samuwall/hiiri-v1/README.md

### open-source wireless gaming mouse

mouse: nRF52820 + PAW3395 + SPDT L/R + EC10E

dongle: nRF52840
