samuwall/hiiri-v1/tools/README.md

### tools/

`hiiri-cfg.c`: mouse config GUI

`libusb-set.c`: mouse config CLI

`libusb-vbat.c`: read mouse battery level
