samuwall/hiiri-v1/hw/mouse/README.md

### hw/mouse

pcb made with KiCad

shell made with FreeCAD

warning: chip antenna is not impedance matched, RF performance is terrible. i plan on impedance matching hiiri-v2, which will use the new nRF54L.

---

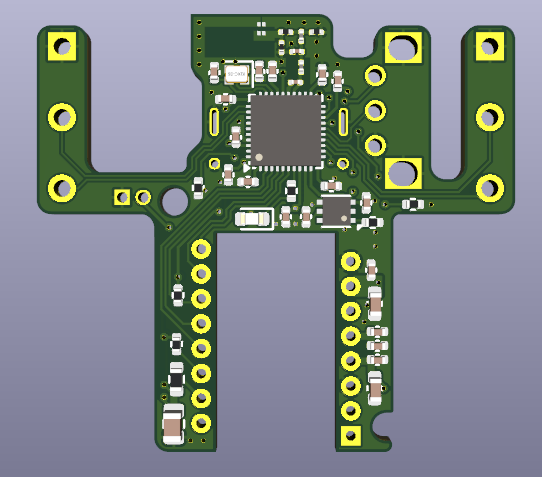
[picture p1: hw/mouse/pcb.png]

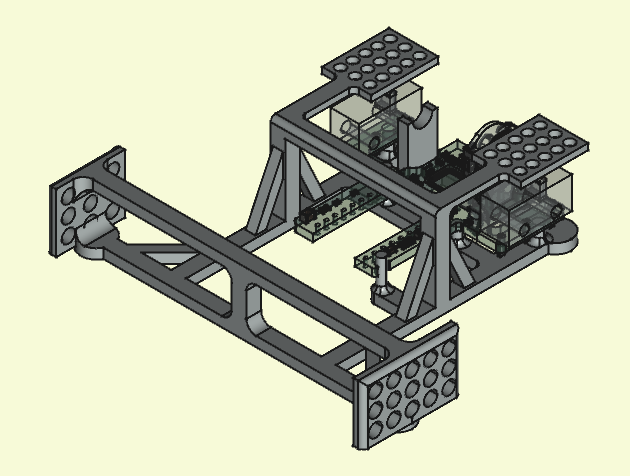
[picture p2: hw/mouse/shell.png]

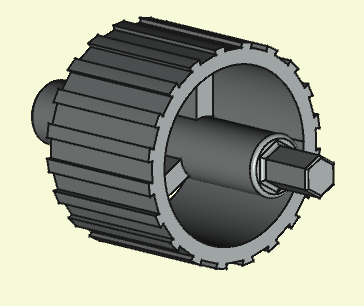
[picture p3: hw/mouse/scroll.png]
