samuwall/hiiri-v1/fw/dongle/README.md

### fw/dongle

firmware for an accompanying nRF52840 dongle

can use any board, just edit the `LED_PIN` macro
