samuwall/hiiri-v1/hw/dongle/README.md

### hw/dongle

any nRF52840 board with a USB connector and user LED will work, as long as `LED_PIN` from `fw/dongle/src/dongle.c` is edited accordingly.
