samuwall/hiiri-v1/hw/mouse/kicad/step-files/D2F_01F.step

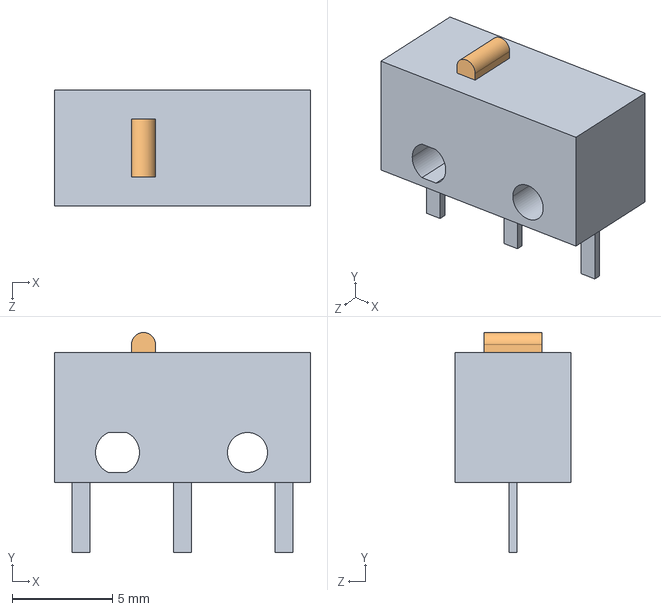
[picture p5: CAD file, 2025-09-14]
hw/mouse/kicad/step-files/D2F_01F.step
12.8 x 11.0 x 5.80 mm
D2F_01F_BASE
D2F_01F_ACTUATOR
