samuwall/hiiri-v1/hw/mouse/freecad/scroll.FCStd

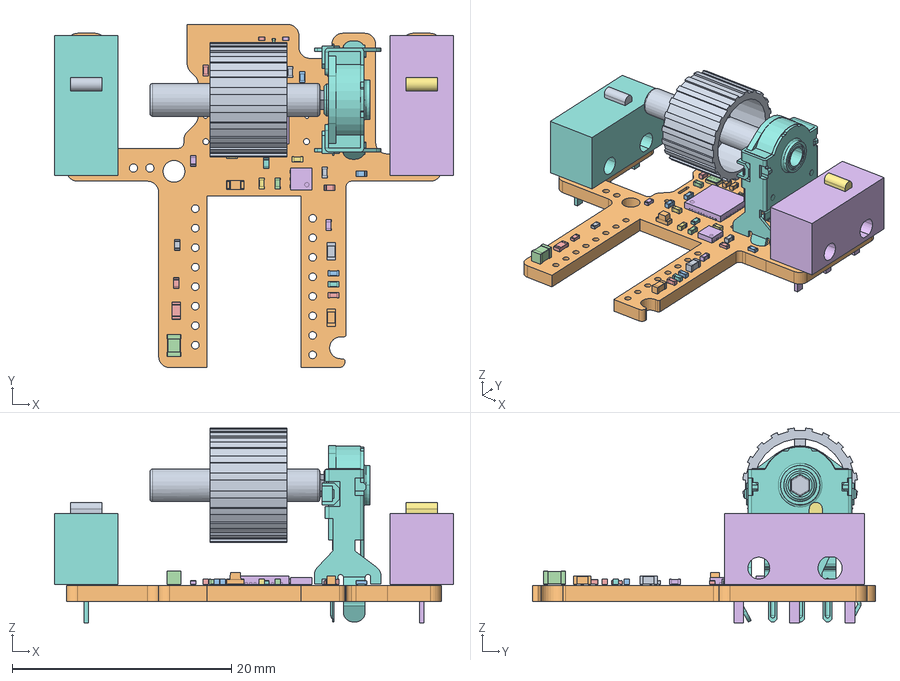
[picture p6: CAD file, 2025-09-14]
hw/mouse/freecad/scroll.FCStd
36.4 x 31.3 x 17.8 mm
C_0402_1005Metric
C_0402_1005Metric001
C_0805_2012Metric
R_0402_1005Metric
DFN-6-1EP_2x2mm_P0.65mm_EP1x1.6mm
C_0201_0603Metric
nrf52820_hiiri 1.7
R_0402_1005Metric001
C_0201_0603Metric001
C_0402_1005Metric002
R_0201_0603Metric
R_0201_0603Metric001
D2F_01F_BASE
D2F_01F_ACTUATOR
C_0402_1005Metric003
C_0603_1608Metric
C_0603_1608Metric001
R_0402_1005Metric002
C_0402_1005Metric004
R_0603_1608Metric
C_0402_1005Metric005
C_0402_1005Metric006
L_0201_0603Metric
C_0402_1005Metric007
LED_0603_1608Metric
C_0402_1005Metric008
C_0402_1005Metric009
R_0402_1005Metric003
QFN-40-1EP_5x5mm_P0.4mm_EP3.6x3.6mm
C_0402_1005Metric010
R_0402_1005Metric004
C_0402_1005Metric011
C_0402_1005Metric012
C_0402_1005Metric013
L_0201_0603Metric001
C_0402_1005Metric014
R_0201_0603Metric002
Pins
Pins001
Pins002
Pins003
Cover
C_0402_1005Metric015
R_0402_1005Metric005
C_0402_1005Metric016
D2F_01F_BASE001
D2F_01F_ACTUATOR001
nrf52820_hiiri_PCB
