samuwall/hiiri-v1/hw/mouse/kicad/step-files/EC10E1220501.step

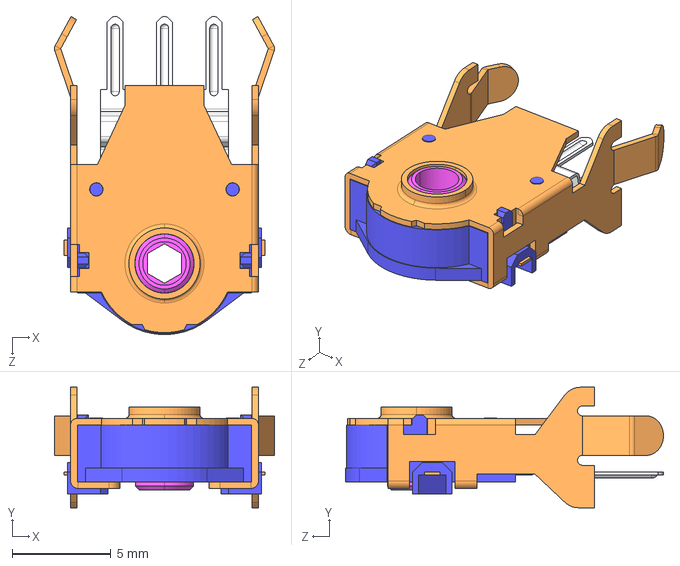
[picture p7: CAD file, 2025-09-14]
hw/mouse/kicad/step-files/EC10E1220501.step
11.1 x 6.10 x 16.1 mm
