samuwall/hiiri-v1/hw/mouse/kicad/step-files/XTAL_SMD1612.step

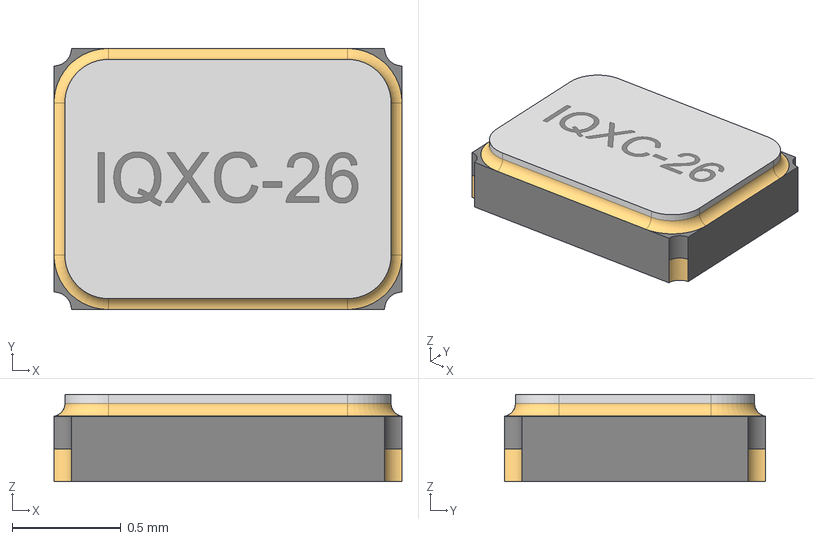
[picture p8: CAD file, 2025-09-14]
hw/mouse/kicad/step-files/XTAL_SMD1612.step
1.60 x 1.20 x 0.4 mm
Pins
Cover
