samuwall/hiiri-v1/hw/mouse/kicad/step-files/EC10E1220503.step

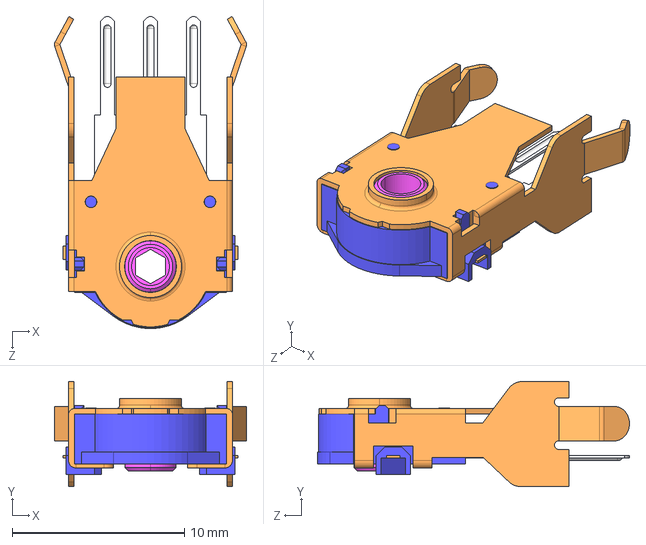
[picture p9: CAD file, 2025-09-14]
hw/mouse/kicad/step-files/EC10E1220503.step
11.1 x 6.10 x 18.1 mm
