samuwall/hiiri-v1/hw/mouse/kicad/step-files/EC10E1220505.step

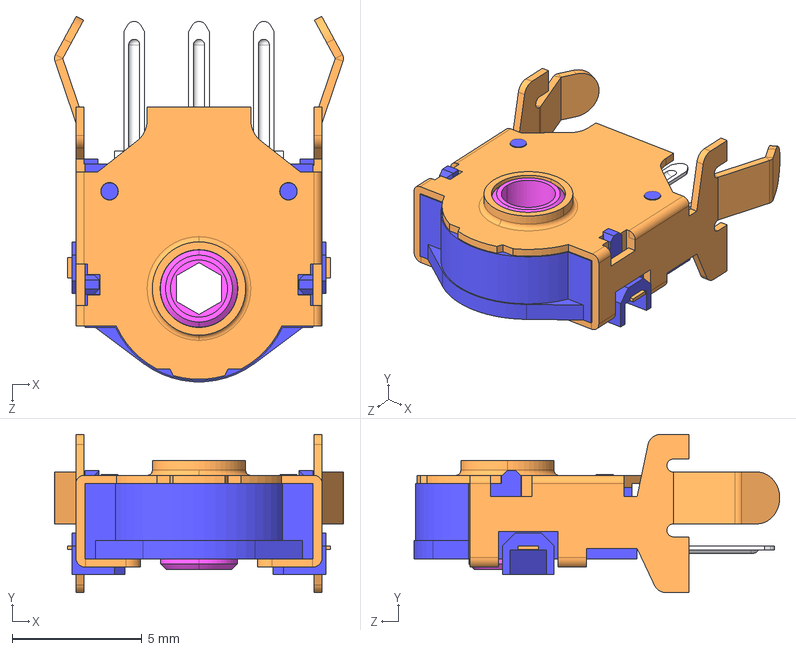
[picture p10: CAD file, 2025-09-14]
hw/mouse/kicad/step-files/EC10E1220505.step
11.1 x 6.10 x 14.1 mm
