samuwall/hiiri-v1/(list of files, cad)

Other CAD files:
hw/mouse/freecad/scroll.stl
hw/mouse/freecad/shell.stl
