samuwall/hiiri-v1/hw/mouse/kicad/nrf52820_hiiri.kicad_pcb

## KiCad design hw/mouse/kicad/nrf52820_hiiri.kicad_pcb (2025-09-14)

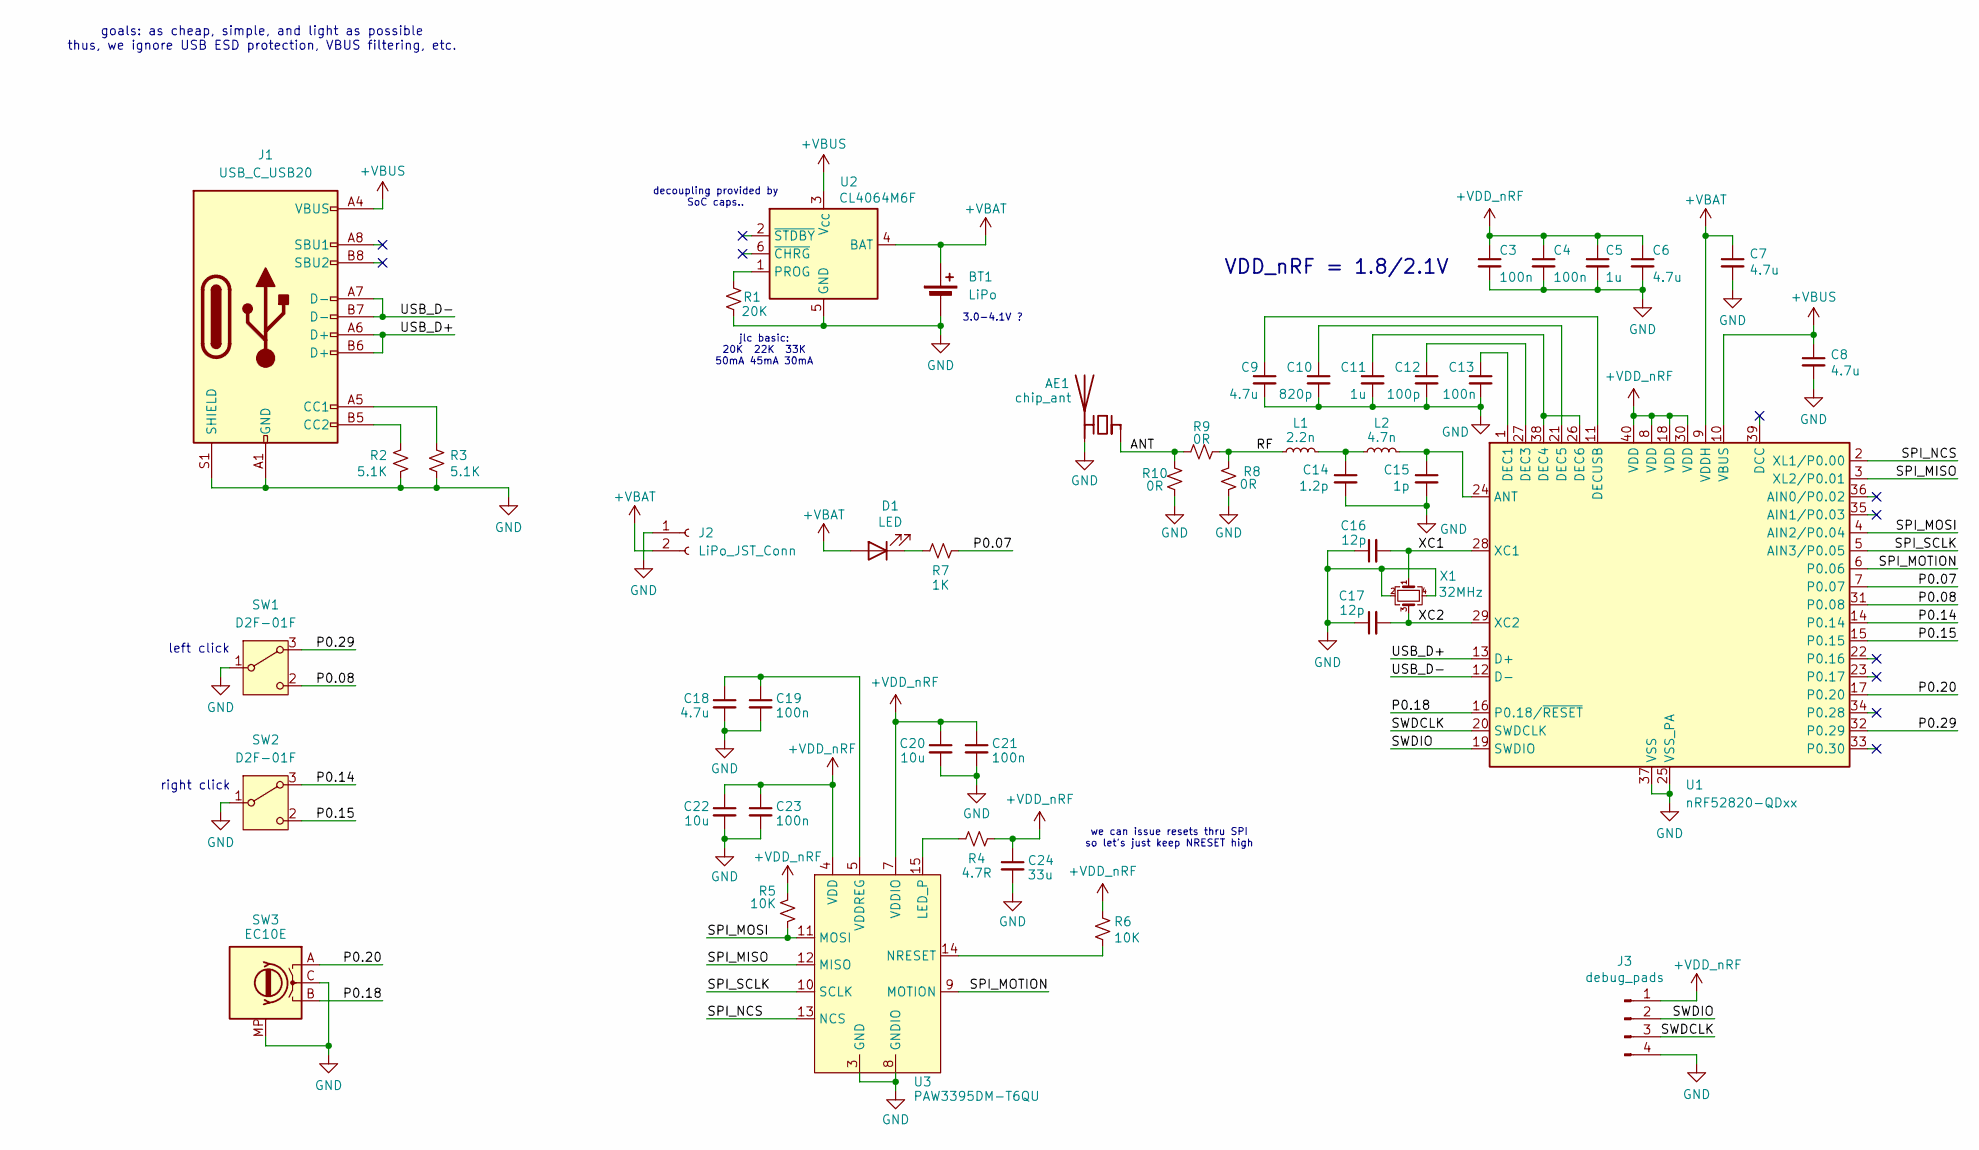
[picture p11: schematic nrf52820_hiiri.kicad_sch]

Parts:
AE1: chip_ant; 5x3mm_Chip_Ant_Layout_Mirrored
BT1: LiPo
C3, C4, C13, C19, C21, C23: 100n; C_0402_1005Metric; LCSC P/N C1525
C5, C11: 1u; C_0402_1005Metric; LCSC P/N C52923
C6, C7, C8, C9, C18: 4.7u; C_0402_1005Metric; LCSC P/N C23733
C10: 820p; C_0402_1005Metric; LCSC P/N C107031
C12: 100p; C_0402_1005Metric; LCSC P/N C1546
C14: 1.2p; C_0201_0603Metric; LCSC P/N C326704
C15: 1p; C_0201_0603Metric; LCSC P/N C541168
C16, C17: 12p; C_0402_1005Metric; LCSC P/N C1547
C20, C22: 10u; C_0603_1608Metric; LCSC P/N C19702
C24: 33u; C_0805_2012Metric; LCSC P/N C342635
D1: LED; LED_0603_1608Metric; LCSC P/N C2290
J1: USB_C_USB20; USB_C_Receptacle_GT-USB-7025; LCSC P/N C963213
J2: LiPo_JST_Conn; 1x02_PTH
J3: debug_pads; 1x4_0.7mm_1.27mm_Test_Pads
L1: 2.2n; L_0201_0603Metric; LCSC P/N C98041
L2: 4.7n; L_0201_0603Metric; LCSC P/N C86126
R1: 20K; R_0402_1005Metric; LCSC P/N C25765
R2, R3: 5.1K; R_0402_1005Metric; LCSC P/N C25905
R4: 4.7R; R_0603_1608Metric; LCSC P/N C23164
R5, R6: 10K; R_0402_1005Metric; LCSC P/N C25744
R7: 1K; R_0402_1005Metric; LCSC P/N C11702
R8, R9, R10: 0R; R_0201_0603Metric; LCSC P/N C17168
SW1, SW2: D2F-01F; SW_D2F-01F_OMR
SW3: EC10E; RotaryEncoder_Alps_EC10E-Switch
U1: nRF52820-QDxx; QFN-40-1EP_5x5mm_P0.4mm_0.2mm_PAD; LCSC P/N C3015612
U2: CL4064M6F; DFN-6-1EP_2x2mm_P0.65mm_EP1x1.6mm; LCSC P/N C5297631
U3: PAW3395DM-T6QU; PIXART_SENSOR_Offset_16-PDIP
X1: 32MHz; Crystal_SMD_1612-4Pin_1.6x1.2mm; LCSC P/N C5203640

Connections:
+VBAT: BT1.1 (+), C7.1, D1.2 (A), J2.2, U1.9 (VDDH), U2.4 (BAT)
+VBUS: C8.1, J1.A4 (VBUS), J1.A9 (VBUS), J1.B4 (VBUS), J1.B9 (VBUS), U1.10 (VBUS), U2.3 (V_{CC})
+VDD_nRF: C3.1, C4.1, C5.1, C6.1, C20.1, C21.1, C22.1, C23.1, C24.1, J3.1, R4.2, R5.1, R6.1, U1.8 (VDD), U1.18 (VDD), U1.30 (VDD), U1.40 (VDD), U3.4 (VDD), U3.7 (VDDIO)
/ANT: AE1.1 (FEED), R9.1, R10.1
/P0.07: R7.2, U1.7 (P0.07)
/P0.08: SW1.2 (C), U1.31 (P0.08)
/P0.14: SW2.3 (A), U1.14 (P0.14)
/P0.15: SW2.2 (C), U1.15 (P0.15)
/P0.18: SW3.B, U1.16 (P0.18/~RESET)
/P0.20: SW3.A, U1.17 (P0.20)
/P0.29: SW1.3 (A), U1.32 (P0.29)
/RF: L1.1, R8.1, R9.2
/SPI_MISO: U1.3 (XL2/P0.01), U3.12 (MISO)
/SPI_MOSI: R5.2, U1.4 (AIN2/P0.04), U3.11 (MOSI)
/SPI_MOTION: U1.6 (P0.06), U3.9 (MOTION)
/SPI_NCS: U1.2 (XL1/P0.00), U3.13 (NCS)
/SPI_SCLK: U1.5 (AIN3/P0.05), U3.10 (SCLK)
/SWDCLK: J3.3, U1.20 (SWDCLK)
/SWDIO: J3.2, U1.19 (SWDIO)
/USB_D+: J1.A6 (D+), J1.B6 (D+), U1.13 (D+)
/USB_D-: J1.A7 (D-), J1.B7 (D-), U1.12 (D-)
/XC1: C16.2, U1.28 (XC1), X1.1
/XC2: C17.2, U1.29 (XC2), X1.3
GND: AE1.2 (PCB_Trace), BT1.2 (-), C3.2, C4.2, C5.2, C6.2, C7.2, C8.2, C9.2, C10.2, C11.2, C12.2, C13.2, C14.2, C15.2, C16.1, C17.1, C18.2, C19.2, C20.2, C21.2, C22.2, C23.2, C24.2, J1.A1 (GND), J1.A12 (GND), J1.B1 (GND), J1.B12 (GND), J1.GND, J1.S1 (SHIELD), J2.1, J3.4, R1.2, R2.2, R3.2, R8.2, R10.2, SW1.1 (B), SW2.1 (B), SW3.C, SW3.MP, U1.25 (VSS_PA), U1.37 (VSS), U1.41 (VSS), U2.5 (GND), U2.7 (GND), U3.3 (GND), U3.8 (GNDIO), X1.2, X1.4
unnamed: C14.1, L1.2, L2.1
unnamed: D1.1 (K), R7.1
unnamed: J1.A5 (CC1), R3.1
unnamed: J1.B5 (CC2), R2.1
unnamed: C15.1, L2.2, U1.24 (ANT)
unnamed: C13.1, U1.1 (DEC1)
unnamed: C12.1, U1.27 (DEC3)
unnamed: C11.1, U1.26 (DEC6), U1.38 (DEC4)
unnamed: C10.1, U1.21 (DEC5)
unnamed: C9.1, U1.11 (DECUSB)
unnamed: R1.1, U2.1 (PROG)
unnamed: R4.1, U3.15 (LED_P)
unnamed: R6.2, U3.14 (NRESET)
unnamed: C18.1, C19.1, U3.5 (VDDREG)

Notes on the sheet:
goals: as cheap, simple, and light as possible thus, we ignore USB ESD protection, VBUS filtering, etc.
VDD_nRF = 1.8/2.1V
we can issue resets thru SPI so let's just keep NRESET high
3.0-4.1V ?
left click
decoupling provided by SoC caps..
jlc basic: 20K 22K 33K 50mA 45mA 30mA
right click

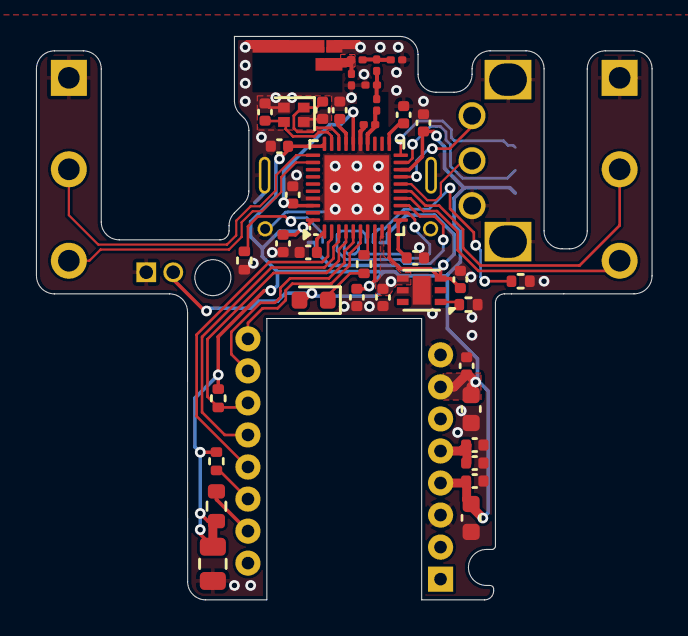
[picture p12: board nrf52820_hiiri.kicad_pcb from above]

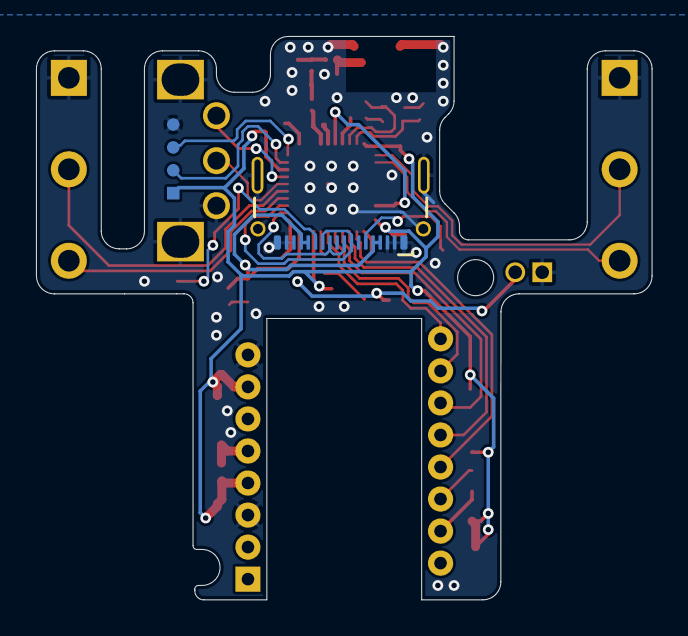
[picture p13: board nrf52820_hiiri.kicad_pcb from below]

Board: 2 copper layers, 34.2 x 31.3 mm, 46 parts (2 on the bottom side), 38 nets.
