samuwall/hiiri-v1/fw/dongle/include/utils.h

/**********************************************************************************
 ** file            : utils.h
 ** description     : simple implementations of libc functions
 ** 
 **********************************************************************************/

#ifndef UTILS_H
#define UTILS_H

#include <stdint.h>
#include <stddef.h>

#define MIN(a, b)       ((a) < (b) ? (a) : (b))
#define ARR_SIZE(x)     (sizeof(x) / sizeof((x)[0]))

void *my_memcpy(void *dest, const void *src, size_t len);
void *my_memset(void *dest, int c, size_t len);
size_t my_strlen(const char *str);

#endif
